d4vid-le/qt-py-esp32-s2-experiment/exports/renders/mockup/bottom.png

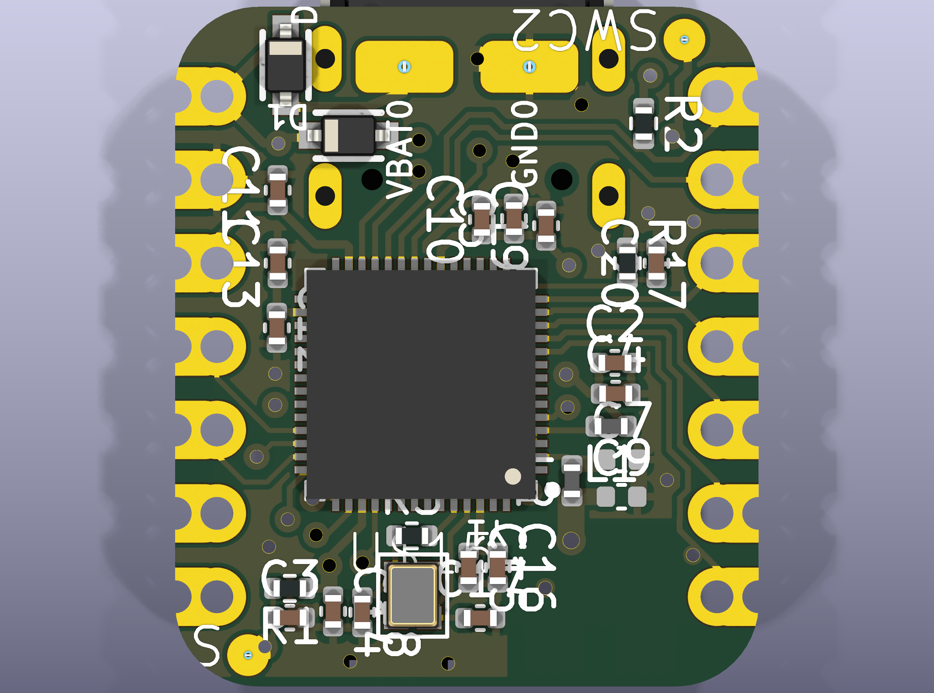
exports/renders/mockup/bottom.png
