d4vid-le/qt-py-esp32-s2-experiment/exports/renders/mockup/top.png

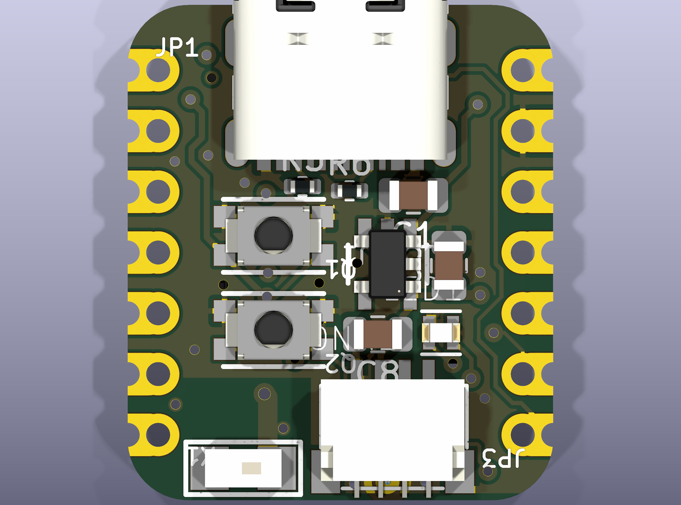
exports/renders/mockup/top.png
