d4vid-le/qt-py-esp32-s2-experiment/reports/gate1-u15-audit.md

# Gate 1 addendum — U$15 (ESP32-S2) pin audit

**Verdict: PASS. 57/57 pads map 1:1 to the ESP32-S2 QFN56 pin table. No
ambiguity remains. Gate 2 may proceed after human review.**

## Exact part number

**ESP32-S2FN4R2** — QFN56, 7×7 mm, 4 MB in-package flash + 2 MB in-package PSRAM.

Evidence:

| Source | What it confirms |
|---|---|
| Adafruit product 5325 | “ESP32-S2 mini-module … 4 MB flash and 2 MB PSRAM” |
| Espressif datasheet **v1.9**, ordering table | `ESP32-S2FN4R2` = 4 MB flash + 2 MB PSRAM, QFN56 |
| Espressif datasheet **v1.9**, package ch. 7 | separate QFN56 package drawing “for ESP32-S2FN4R2” |
| Adafruit-hosted datasheet **v1.1** | 57-pin table used for pin names/functions; **does not list FN4R2** |

The Adafruit-hosted V1.1 predates the FN4R2, which is why the current V1.9 was
used as a supplementary source. V1.9 was downloaded from
`documentation.espressif.com` and kept in `reference/assets/` (gitignored).

## Library discrepancy found (label only)

| Eagle field | Value | Reality |
|---|---|---|
| Symbol | `ESP-32-S2` | okay |
| Device | `QFN54` | **mislabelled** — no QFN54 exists in this family |
| Package | `QFN56_7X7` | correct: 56 pins + exposed pad = **57 pads** |
| Pads | 57, contiguous 1..57 | correct, no gaps or duplicates |

No electrical impact. Recorded as a source quirk.

## Nomenclature differences (all normalized, all match)

| Eagle | Datasheet | Count |
|---|---|---:|
| `IO0` … `IO46` | `GPIO0` … `GPIO46` | 26 |
| `MTD0` (zero) | `MTDO` (letter O) | 1 |
| `VDDA@0/@1/@2` | `VDDA` | 3 |
| `VDD3P3@0/@1` | `VDD3P3` | 2 |
| `GND@0` | `GND` | 1 |

The `@N` suffixes disambiguate repeated names inside one Eagle symbol; they are
not pin numbers.

## Cross-datasheet check

Parsed the 57-pin table from both PDFs independently:

- V1.1: 57 pins, sequential, functions extracted.
- V1.9: 56 numbered pins extracted from Table 2-1; **all 56 names match V1.1**.
- Pin 57 is the exposed pad (`GND`), listed in V1.1 and shown in the V1.9
  QFN56/FN4R2 package drawing rather than Table 2-1.

## FN4R2-specific pins

Pins 29–36 are the in-package flash/PSRAM interface. The datasheet says these
pins “are not recommended for other uses”.

| Pin | Name | Net in this design |
|---:|---|---|
| 29 | SPICS1 | unconnected |
| 30 | VDD_SPI | `VDD_SPI` (C12 0.1 µF + C13 1 µF only) |
| 31 | SPIHD | unconnected |
| 32 | SPIWP | unconnected |
| 33 | SPICS0 | unconnected |
| 34 | SPICLK | unconnected |
| 35 | SPIQ | unconnected |
| 36 | SPID | unconnected |

Leaving 29 and 31–36 unconnected is consistent with in-package memory. VDD_SPI
is deliberately isolated from 3.3 V — this is the Rev C low-power-sleep fix, and
the datasheet allows VDD_SPI to be an output/controlled rail.

## Connectivity summary

- 57 pads audited
- 33 connected to a net
- 24 unconnected (all GPIO/SPI/UART/32k pins, audited in Gate 0)
- 0 name mismatches
- 0 duplicate pads
- 0 gaps

## Full table

Source: `design/u15-pinmap.csv` (generated by `scripts/make_u15_audit.py`).

| Eagle pin | Pad | DS pin | DS name | Net | Function | Check |
|---|---:|---:|---|---|---|---|
| `VDDA@0` | 1 | 1 | `VDDA` | `3.3V` | Analog power supply | match |
| `LNA_IN` | 2 | 2 | `LNA_IN` | `N$2` | RF input and output | match |
| `VDD3P3@0` | 3 | 3 | `VDD3P3` | `VDD3P3` | Analog power supply | match |
| `VDD3P3@1` | 4 | 4 | `VDD3P3` | `VDD3P3` | Analog power supply | match |
| `IO0` | 5 | 5 | `GPIO0` | `IO0` | RTC_GPIO0, GPIO0 | match |
| `IO1` | 6 | 6 | `GPIO1` | `(unconnected)` | RTC_GPIO1, GPIO1, TOUCH1, ADC1_CH0 | match |
| `IO2` | 7 | 7 | `GPIO2` | `(unconnected)` | RTC_GPIO2, GPIO2, TOUCH2, ADC1_CH1 | match |
| `IO3` | 8 | 8 | `GPIO3` | `(unconnected)` | RTC_GPIO3, GPIO3, TOUCH3, ADC1_CH2 | match |
| `IO4` | 9 | 9 | `GPIO4` | `(unconnected)` | RTC_GPIO4, GPIO4, TOUCH4, ADC1_CH3 | match |
| `IO5` | 10 | 10 | `GPIO5` | `TX` | RTC_GPIO5, GPIO5, TOUCH5, ADC1_CH4 | match |
| `IO6` | 11 | 11 | `GPIO6` | `SCL` | RTC_GPIO6, GPIO6, TOUCH6, ADC1_CH5 | match |
| `IO7` | 12 | 12 | `GPIO7` | `SDA` | RTC_GPIO7, GPIO7, TOUCH7, ADC1_CH6 | match |
| `IO8` | 13 | 13 | `GPIO8` | `A3` | RTC_GPIO8, GPIO8, TOUCH8, ADC1_CH7 | match |
| `IO9` | 14 | 14 | `GPIO9` | `A2` | RTC_GPIO9, GPIO9, TOUCH9, ADC1_CH8, FSPIHD | match |
| `IO10` | 15 | 15 | `GPIO10` | `IO10_DBLTAP` | RTC_GPIO10, GPIO10, TOUCH10, ADC1_CH9, FSPICS0, FSPIIO4 | match |
| `IO11` | 16 | 16 | `GPIO11` | `(unconnected)` | RTC_GPIO11, GPIO11, TOUCH11, ADC2_CH0, FSPID, FSPIIO5 | match |
| `IO12` | 17 | 17 | `GPIO12` | `(unconnected)` | RTC_GPIO12, GPIO12, TOUCH12, ADC2_CH1, FSPICLK, FSPIIO6 | match |
| `IO13` | 18 | 18 | `GPIO13` | `(unconnected)` | RTC_GPIO13, GPIO13, TOUCH13, ADC2_CH2, FSPIQ, FSPIIO7 | match |
| `IO14` | 19 | 19 | `GPIO14` | `(unconnected)` | RTC_GPIO14, GPIO14, TOUCH14, ADC2_CH3, FSPIWP, FSPIDQS | match |
| `VDD3P3_RTC` | 20 | 20 | `VDD3P3_RTC` | `3.3V` | Analog power supply | match |
| `XTAL_32K_P` | 21 | 21 | `XTAL_32K_P` | `(unconnected)` | RTC_GPIO15, GPIO15, U0RTS, ADC2_CH4, XTAL_32K_P | match |
| `XTAL_32K_N` | 22 | 22 | `XTAL_32K_N` | `RX` | RTC_GPIO16, GPIO16, U0CTS, ADC2_CH5, XTAL_32K_N | match |
| `DAC_1` | 23 | 23 | `DAC_1` | `A1` | RTC_GPIO17, GPIO17, U1TXD, ADC2_CH6, DAC_1 | match |
| `DAC_2` | 24 | 24 | `DAC_2` | `A0` | RTC_GPIO18, GPIO18, U1RXD, ADC2_CH7, DAC_2 | match |
| `IO19` | 25 | 25 | `GPIO19` | `D-` | RTC_GPIO19, GPIO19, U1RTS, ADC2_CH8, CLK_OUT2, USB_D- | match |
| `IO20` | 26 | 26 | `GPIO20` | `D+` | RTC_GPIO20, GPIO20, U1CTS, ADC2_CH9, CLK_OUT1, USB_D+ | match |
| `VDD3P3_RTC_IO` | 27 | 27 | `VDD3P3_RTC_IO` | `3.3V` | Input power supply for RTC IO | match |
| `IO21` | 28 | 28 | `GPIO21` | `(unconnected)` | RTC_GPIO21, GPIO21 | match |
| `SPICS1` | 29 | 29 | `SPICS1` | `(unconnected)` | SPICS1, GPIO26 | match |
| `VDD_SPI` | 30 | 30 | `VDD_SPI` | `VDD_SPI` | Output power supply: 1.8 V or same as VDD3P3_RTC_IO | match |
| `SPIHD` | 31 | 31 | `SPIHD` | `(unconnected)` | SPIHD, GPIO27 | match |
| `SPIWP` | 32 | 32 | `SPIWP` | `(unconnected)` | SPIWP, GPIO28 | match |
| `SPICS0` | 33 | 33 | `SPICS0` | `(unconnected)` | SPICS0, GPIO29 | match |
| `SPICLK` | 34 | 34 | `SPICLK` | `(unconnected)` | SPICLK, GPIO30 | match |
| `SPIQ` | 35 | 35 | `SPIQ` | `(unconnected)` | SPIQ, GPIO31 | match |
| `SPID` | 36 | 36 | `SPID` | `(unconnected)` | SPID, GPIO32 | match |
| `IO33` | 37 | 37 | `GPIO33` | `(unconnected)` | SPIIO4, GPIO33, FSPIHD | match |
| `IO34` | 38 | 38 | `GPIO34` | `(unconnected)` | SPIIO5, GPIO34, FSPICS0 | match |
| `IO35` | 39 | 39 | `GPIO35` | `MOSI` | SPIIO6, GPIO35, FSPID | match |
| `IO36` | 40 | 40 | `GPIO36` | `SCK` | SPIIO7, GPIO36, FSPICLK | match |
| `IO37` | 41 | 41 | `GPIO37` | `MISO` | SPIDQS, GPIO37, FSPIQ | match |
| `IO38` | 42 | 42 | `GPIO38` | `NEOPIX_PWR` | GPIO38, FSPIWP | match |
| `MTCK` | 43 | 43 | `MTCK` | `NEOPIX` | MTCK, GPIO39, CLK_OUT3 | match |
| `MTD0` | 44 | 44 | `MTDO` | `SCL1` | MTDO, GPIO40, CLK_OUT2 | match |
| `VDD3P3_CPU` | 45 | 45 | `VDD3P3_CPU` | `3.3V` | Input power supply for CPU IO | match |
| `MTDI` | 46 | 46 | `MTDI` | `SDA1` | MTDI, GPIO41, CLK_OUT1 | match |
| `MTMS` | 47 | 47 | `MTMS` | `(unconnected)` | MTMS, GPIO42 | match |
| `U0TXD` | 48 | 48 | `U0TXD` | `(unconnected)` | U0TXD, GPIO43, CLK_OUT1 | match |
| `U0RXD` | 49 | 49 | `U0RXD` | `(unconnected)` | U0RXD, GPIO44, CLK_OUT2 | match |
| `IO45` | 50 | 50 | `GPIO45` | `(unconnected)` | GPIO45 | match |
| `VDDA@1` | 51 | 51 | `VDDA` | `3.3V` | Analog power supply | match |
| `XTAL_N` | 52 | 52 | `XTAL_N` | `N$5` | External crystal output | match |
| `XTAL_P` | 53 | 53 | `XTAL_P` | `N$6` | External crystal input | match |
| `VDDA@2` | 54 | 54 | `VDDA` | `3.3V` | Analog power supply | match |
| `IO46` | 55 | 55 | `GPIO46` | `(unconnected)` | GPIO46 | match |
| `CHIP_PU` | 56 | 56 | `CHIP_PU` | `!RESET` | High: on; low: off. Do not leave floating. | match |
| `GND@0` | 57 | 57 | `GND` | `GND` | Ground (exposed pad) | match |

## Commands used

```sh
curl -o reference/assets/esp32-s2_datasheet.pdf \
  https://cdn-learn.adafruit.com/assets/assets/000/096/705/original/esp32-s2_datasheet_en.pdf
curl -o reference/assets/esp32-s2_datasheet_current.pdf \
  https://documentation.espressif.com/esp32-s2_datasheet_en.pdf

python3 scripts/parse_esp32s2_pins.py \
  reference/assets/esp32-s2_datasheet.pdf reference/imported-kicad/esp32s2-pins.csv

python3 scripts/make_u15_audit.py \
  "reference/eagle/Adafruit QT Py ESP32-S2 Rev C.sch" \
  reference/imported-kicad/esp32s2-pins.csv \
  design/netlist_original.csv \
  design/u15-pinmap.csv
```

## Ambiguities

**None blocking.** One documented limitation: the Adafruit-hosted datasheet
(V1.1) does not cover the FN4R2; the current Espressif V1.9 was used to confirm
the part number and pin numbering. Both agree on all 56 numbered pins.
