d4vid-le/qt-py-esp32-s2-experiment/reports/gate0-nets.md

# Gate 0 — Rev C net detail (from .sch)

Physical pad connections. One row per pad; a pin with several pads appears several times.

## !RESET  (6 pads, class 0)

- `C3.1` — 1uF (_0402NO) pin `1`
- `Q2.A` — reset (BTN_KMR2_4.6X2.8) pin `P`
- `Q2.A'` — reset (BTN_KMR2_4.6X2.8) pin `P1`
- `R1.2` — 10K (_0402NO) pin `2`
- `SWC1.TP` — TPB1,27 (B1,27) pin `TP`
- `U$15.56` —  (QFN56_7X7) pin `CHIP_PU`

## +5V  (10 pads, class 1)

- `C1.1` — 22uF (0805-NO) pin `1`
- `D1.C` —   NSR0320 (SOD-323_MINI) pin `C`
- `D2.C` —   NSR0320 (SOD-323_MINI) pin `C`
- `JP3.7` —  (1X07_CASTEL) pin `7`
- `JP3.7C` —  (1X07_CASTEL) pin `7`
- `SUPPLY1.+5V` —  (symbol) pin `+5V`
- `SUPPLY2.+5V` —  (symbol) pin `+5V`
- `SUPPLY3.+5V` —  (symbol) pin `+5V`
- `U1.1` — AP2112K-3.3 (SOT23-5) pin `IN`
- `U1.3` — AP2112K-3.3 (SOT23-5) pin `EN`

## 3.3V  (34 pads, class 1)

- `C10.1` — 0.1uF (_0402NO) pin `1`
- `C11.1` — 0.1uF (_0402NO) pin `1`
- `C14.1` — 0.1uF (_0402NO) pin `1`
- `C15.1` — 1uF (_0402NO) pin `1`
- `C16.1` — 100pF (_0402NO) pin `1`
- `C19.1` — 1uF (_0402NO) pin `1`
- `C2.1` — 1uF (_0402NO) pin `1`
- `C4.1` — 0.1uF (_0402NO) pin `1`
- `C5.1` — 1uF (_0402NO) pin `1`
- `C6.1` — 22uF (0805-NO) pin `1`
- `C8.1` — 22uF (0805-NO) pin `1`
- `CONN1.2` — STEMMA_I2C_QTSKINNY (JST_SH4_SKINNY) pin `V+`
- `JP3.5` —  (1X07_CASTEL) pin `5`
- `JP3.5C` —  (1X07_CASTEL) pin `5`
- `L1.1` — 2nH (_0402) pin `1`
- `R1.1` — 10K (_0402NO) pin `1`
- `R2.1` — 10K (_0402NO) pin `1`
- `U$10.3.3V` —  (symbol) pin `3.3V`
- `U$15.1` —  (QFN56_7X7) pin `VDDA@0`
- `U$15.20` —  (QFN56_7X7) pin `VDD3P3_RTC`
- `U$15.27` —  (QFN56_7X7) pin `VDD3P3_RTC_IO`
- `U$15.45` —  (QFN56_7X7) pin `VDD3P3_CPU`
- `U$15.51` —  (QFN56_7X7) pin `VDDA@1`
- `U$15.54` —  (QFN56_7X7) pin `VDDA@2`
- `U$16.3.3V` —  (symbol) pin `3.3V`
- `U$17.3.3V` —  (symbol) pin `3.3V`
- `U$19.3.3V` —  (symbol) pin `3.3V`
- `U$2.3.3V` —  (symbol) pin `3.3V`
- `U$20.3.3V` —  (symbol) pin `3.3V`
- `U$21.3.3V` —  (symbol) pin `3.3V`
- `U$23.3.3V` —  (symbol) pin `3.3V`
- `U$24.3.3V` —  (symbol) pin `3.3V`
- `U$4.3.3V` —  (symbol) pin `3.3V`
- `U1.5` — AP2112K-3.3 (SOT23-5) pin `OUT`

## A0  (4 pads, class 0)

- `JP1.1` —  (1X07_CASTEL) pin `1`
- `JP1.1C` —  (1X07_CASTEL) pin `1`
- `R2.2` — 10K (_0402NO) pin `2`
- `U$15.24` —  (QFN56_7X7) pin `DAC_2`

## A1  (3 pads, class 0)

- `JP1.2` —  (1X07_CASTEL) pin `2`
- `JP1.2C` —  (1X07_CASTEL) pin `2`
- `U$15.23` —  (QFN56_7X7) pin `DAC_1`

## A2  (3 pads, class 0)

- `JP1.3` —  (1X07_CASTEL) pin `3`
- `JP1.3C` —  (1X07_CASTEL) pin `3`
- `U$15.14` —  (QFN56_7X7) pin `IO9`

## A3  (3 pads, class 0)

- `JP1.4` —  (1X07_CASTEL) pin `4`
- `JP1.4C` —  (1X07_CASTEL) pin `4`
- `U$15.13` —  (QFN56_7X7) pin `IO8`

## CC1  (2 pads, class 0)

- `R6.2` — 5.1K (_0402NO) pin `2`
- `X6.A5` — USB TYPE C (USB_C_CUSB31-CFM2AX-01-X) pin `CC1`

## CC2  (2 pads, class 0)

- `R5.2` — 5.1K (_0402NO) pin `2`
- `X6.B5` — USB TYPE C (USB_C_CUSB31-CFM2AX-01-X) pin `CC2`

## D+  (3 pads, class 0)

- `U$15.26` —  (QFN56_7X7) pin `IO20`
- `X6.A6` — USB TYPE C (USB_C_CUSB31-CFM2AX-01-X) pin `D+`
- `X6.B6` — USB TYPE C (USB_C_CUSB31-CFM2AX-01-X) pin `D+`

## D-  (3 pads, class 0)

- `U$15.25` —  (QFN56_7X7) pin `IO19`
- `X6.A7` — USB TYPE C (USB_C_CUSB31-CFM2AX-01-X) pin `D-`
- `X6.B7` — USB TYPE C (USB_C_CUSB31-CFM2AX-01-X) pin `D-`

## GND  (70 pads, class 1)

- `C1.2` — 22uF (0805-NO) pin `2`
- `C10.2` — 0.1uF (_0402NO) pin `2`
- `C11.2` — 0.1uF (_0402NO) pin `2`
- `C12.2` — 0.1uF (_0402NO) pin `2`
- `C13.2` — 1uF (_0402NO) pin `2`
- `C14.2` — 0.1uF (_0402NO) pin `2`
- `C15.2` — 1uF (_0402NO) pin `2`
- `C16.2` — 100pF (_0402NO) pin `2`
- `C17.2` — 16pF (_0402NO) pin `2`
- `C18.2` — 16pF (_0402NO) pin `2`
- `C19.2` — 1uF (_0402NO) pin `2`
- `C2.2` — 1uF (_0402NO) pin `2`
- `C20.2` — 1uF (_0402NO) pin `2`
- `C3.2` — 1uF (_0402NO) pin `2`
- `C4.2` — 0.1uF (_0402NO) pin `2`
- `C5.2` — 1uF (_0402NO) pin `2`
- `C6.2` — 22uF (0805-NO) pin `2`
- `C7.2` — TBD (_0402NO) pin `2`
- `C8.2` — 22uF (0805-NO) pin `2`
- `C9.2` — TBD (_0402NO) pin `2`
- `CONN1.1` — STEMMA_I2C_QTSKINNY (JST_SH4_SKINNY) pin `GND`
- `CONN1.MT1` — STEMMA_I2C_QTSKINNY (JST_SH4_SKINNY) pin `MT`
- `CONN1.MT2` — STEMMA_I2C_QTSKINNY (JST_SH4_SKINNY) pin `MT`
- `GND.P$1` —  (TESTPOINT_MINUS_1X3MM) pin `P$1`
- `GND1.GND` —  (symbol) pin `GND`
- `GND10.GND` —  (symbol) pin `GND`
- `GND11.GND` —  (symbol) pin `GND`
- `GND12.GND` —  (symbol) pin `GND`
- `GND13.GND` —  (symbol) pin `GND`
- `GND14.GND` —  (symbol) pin `GND`
- `GND15.GND` —  (symbol) pin `GND`
- `GND16.GND` —  (symbol) pin `GND`
- `GND17.GND` —  (symbol) pin `GND`
- `GND18.GND` —  (symbol) pin `GND`
- `GND19.GND` —  (symbol) pin `GND`
- `GND2.GND` —  (symbol) pin `GND`
- `GND20.GND` —  (symbol) pin `GND`
- `GND21.GND` —  (symbol) pin `GND`
- `GND22.GND` —  (symbol) pin `GND`
- `GND23.GND` —  (symbol) pin `GND`
- `GND24.GND` —  (symbol) pin `GND`
- `GND25.GND` —  (symbol) pin `GND`
- `GND26.GND` —  (symbol) pin `GND`
- `GND27.GND` —  (symbol) pin `GND`
- `GND3.GND` —  (symbol) pin `GND`
- `GND4.GND` —  (symbol) pin `GND`
- `GND5.GND` —  (symbol) pin `GND`
- `GND6.GND` —  (symbol) pin `GND`
- `GND7.GND` —  (symbol) pin `GND`
- `GND8.GND` —  (symbol) pin `GND`
- `GND9.GND` —  (symbol) pin `GND`
- `JP3.6` —  (1X07_CASTEL) pin `6`
- `JP3.6C` —  (1X07_CASTEL) pin `6`
- `LED1.4` — WS2812B_SK6805_1515 (SK6805_1515) pin `GND`
- `Q1.B` — BOOT0 (BTN_KMR2_4.6X2.8) pin `S`
- `Q1.B'` — BOOT0 (BTN_KMR2_4.6X2.8) pin `S1`
- `Q2.B` — reset (BTN_KMR2_4.6X2.8) pin `S`
- `Q2.B'` — reset (BTN_KMR2_4.6X2.8) pin `S1`
- `R17.1` — 1Meg (_0402NO) pin `1`
- `R5.1` — 5.1K (_0402NO) pin `1`
- `R6.1` — 5.1K (_0402NO) pin `1`
- `U$1.GND` —  (symbol) pin `GND`
- `U$14.GND` —  (symbol) pin `GND`
- `U$15.57` —  (QFN56_7X7) pin `GND@0`
- `U$26.GND` —  (symbol) pin `GND`
- `U$40.GND` —  (symbol) pin `GND`
- `U$9.GND` —  (symbol) pin `GND`
- `U1.2` — AP2112K-3.3 (SOT23-5) pin `GND`
- `X6.A1B12` — USB TYPE C (USB_C_CUSB31-CFM2AX-01-X) pin `GND`
- `X6.B1A12` — USB TYPE C (USB_C_CUSB31-CFM2AX-01-X) pin `GND`

## IO0  (4 pads, class 0)

- `Q1.A` — BOOT0 (BTN_KMR2_4.6X2.8) pin `P`
- `Q1.A'` — BOOT0 (BTN_KMR2_4.6X2.8) pin `P1`
- `SWC2.TP` — TPB1,27 (B1,27) pin `TP`
- `U$15.5` —  (QFN56_7X7) pin `IO0`

## IO10_DBLTAP  (3 pads, class 0)

- `C20.1` — 1uF (_0402NO) pin `1`
- `R17.2` — 1Meg (_0402NO) pin `2`
- `U$15.15` —  (QFN56_7X7) pin `IO10`

## MISO  (3 pads, class 0)

- `JP3.3` —  (1X07_CASTEL) pin `3`
- `JP3.3C` —  (1X07_CASTEL) pin `3`
- `U$15.41` —  (QFN56_7X7) pin `IO37`

## MOSI  (3 pads, class 0)

- `JP3.4` —  (1X07_CASTEL) pin `4`
- `JP3.4C` —  (1X07_CASTEL) pin `4`
- `U$15.39` —  (QFN56_7X7) pin `IO35`

## N$2  (3 pads, class 0)

- `C7.1` — TBD (_0402NO) pin `1`
- `L2.2` — 0 ohm (_0402) pin `2`
- `U$15.2` —  (QFN56_7X7) pin `LNA_IN`

## N$3  (3 pads, class 0)

- `C9.1` — TBD (_0402NO) pin `1`
- `L2.1` — 0 ohm (_0402) pin `1`
- `X1.FP` —  (ANT_2450AT18B100) pin `P$1`

## N$5  (2 pads, class 0)

- `R3.2` — 0 (_0402NO) pin `2`
- `U$15.52` —  (QFN56_7X7) pin `XTAL_N`

## N$6  (3 pads, class 0)

- `C17.1` — 16pF (_0402NO) pin `1`
- `U$15.53` —  (QFN56_7X7) pin `XTAL_P`
- `Y1.3` — 40MHz (CRYSTAL_2X1.6) pin `2`

## N$7  (3 pads, class 0)

- `C18.1` — 16pF (_0402NO) pin `1`
- `R3.1` — 0 (_0402NO) pin `1`
- `Y1.1` — 40MHz (CRYSTAL_2X1.6) pin `1`

## NEOPIX  (2 pads, class 0)

- `LED1.1` — WS2812B_SK6805_1515 (SK6805_1515) pin `DI`
- `U$15.43` —  (QFN56_7X7) pin `MTCK`

## NEOPIX_PWR  (2 pads, class 0)

- `LED1.2` — WS2812B_SK6805_1515 (SK6805_1515) pin `VDD`
- `U$15.42` —  (QFN56_7X7) pin `IO38`

## RX  (3 pads, class 0)

- `JP3.1` —  (1X07_CASTEL) pin `1`
- `JP3.1C` —  (1X07_CASTEL) pin `1`
- `U$15.22` —  (QFN56_7X7) pin `XTAL_32K_N`

## SCK  (3 pads, class 0)

- `JP3.2` —  (1X07_CASTEL) pin `2`
- `JP3.2C` —  (1X07_CASTEL) pin `2`
- `U$15.40` —  (QFN56_7X7) pin `IO36`

## SCL  (3 pads, class 0)

- `JP1.6` —  (1X07_CASTEL) pin `6`
- `JP1.6C` —  (1X07_CASTEL) pin `6`
- `U$15.11` —  (QFN56_7X7) pin `IO6`

## SCL1  (2 pads, class 0)

- `CONN1.4` — STEMMA_I2C_QTSKINNY (JST_SH4_SKINNY) pin `SCL`
- `U$15.44` —  (QFN56_7X7) pin `MTD0`

## SDA  (3 pads, class 0)

- `JP1.5` —  (1X07_CASTEL) pin `5`
- `JP1.5C` —  (1X07_CASTEL) pin `5`
- `U$15.12` —  (QFN56_7X7) pin `IO7`

## SDA1  (2 pads, class 0)

- `CONN1.3` — STEMMA_I2C_QTSKINNY (JST_SH4_SKINNY) pin `SDA`
- `U$15.46` —  (QFN56_7X7) pin `MTDI`

## TX  (3 pads, class 0)

- `JP1.7` —  (1X07_CASTEL) pin `7`
- `JP1.7C` —  (1X07_CASTEL) pin `7`
- `U$15.10` —  (QFN56_7X7) pin `IO5`

## VBAT  (2 pads, class 0)

- `D2.A` —   NSR0320 (SOD-323_MINI) pin `A`
- `VBAT.P$1` —  (TESTPOINT_PLUS_1X3MM) pin `P$1`

## VBUS  (4 pads, class 1)

- `D1.A` —   NSR0320 (SOD-323_MINI) pin `A`
- `U$5.VBUS` —  (symbol) pin `VBUS`
- `X6.A4B9` — USB TYPE C (USB_C_CUSB31-CFM2AX-01-X) pin `VBUS`
- `X6.B4A9` — USB TYPE C (USB_C_CUSB31-CFM2AX-01-X) pin `VBUS`

## VDD3P3  (3 pads, class 0)

- `L1.2` — 2nH (_0402) pin `2`
- `U$15.3` —  (QFN56_7X7) pin `VDD3P3@0`
- `U$15.4` —  (QFN56_7X7) pin `VDD3P3@1`

## VDD_SPI  (3 pads, class 1)

- `C12.1` — 0.1uF (_0402NO) pin `1`
- `C13.1` — 1uF (_0402NO) pin `1`
- `U$15.30` —  (QFN56_7X7) pin `VDD_SPI`
