d4vid-le/qt-py-esp32-s2-experiment/exports/docs/drill-report.txt

Drill report for qt-py-esp32-s2.kicad_pcb
Created on 2026-10-27T13:43:44

Copper Layer Stackup:
    =============================================================
    L1 :  F.Cu                      front
    L2 :  In1.Cu                    in1
    L3 :  In2.Cu                    in2
    L4 :  B.Cu                      back

Drill file 'qt-py-esp32-s2-PTH.drl' contains
    plated through holes:
    =============================================================
    T1  0.394mm  0.0155"  (11 holes))
    T2  0.400mm  0.0157"  (31 holes))
    T3  0.500mm  0.0197"  (1 hole)
    T4  0.600mm  0.0236"  (4 holes))
    T5  1.000mm  0.0394"  (28 holes))

    Total plated holes count 75

Drill file 'qt-py-esp32-s2-NPTH.drl' contains
    unplated through holes:
    =============================================================
    T1  0.650mm  0.0256"  (2 holes))

    Total unplated holes count 2
