d4vid-le/qt-py-esp32-s2-experiment/exports/renders/2d-copper.png

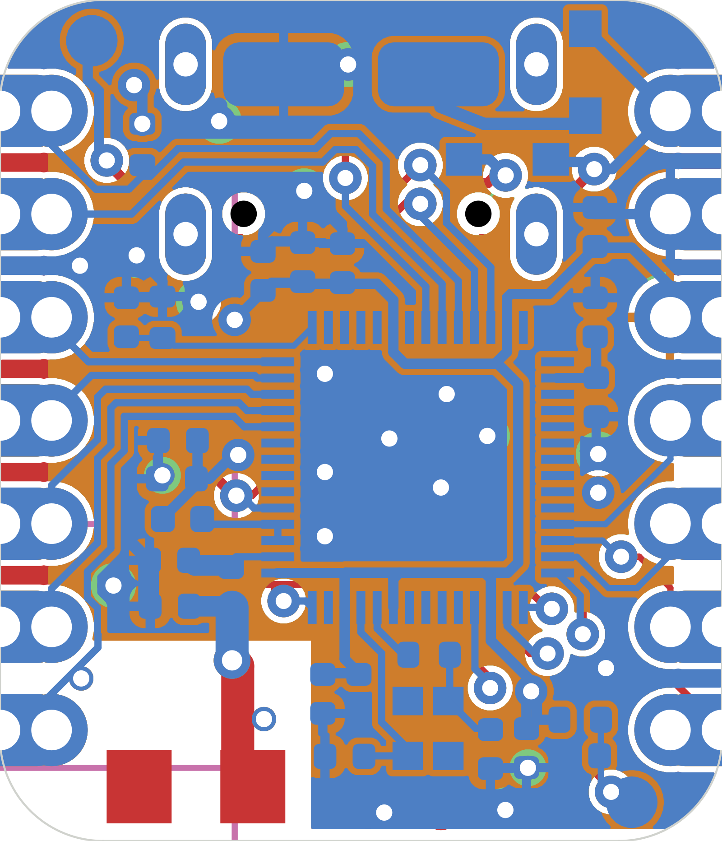
exports/renders/2d-copper.png
