d4vid-le/qt-py-esp32-s2-experiment/exports/renders/3d-bottom.png

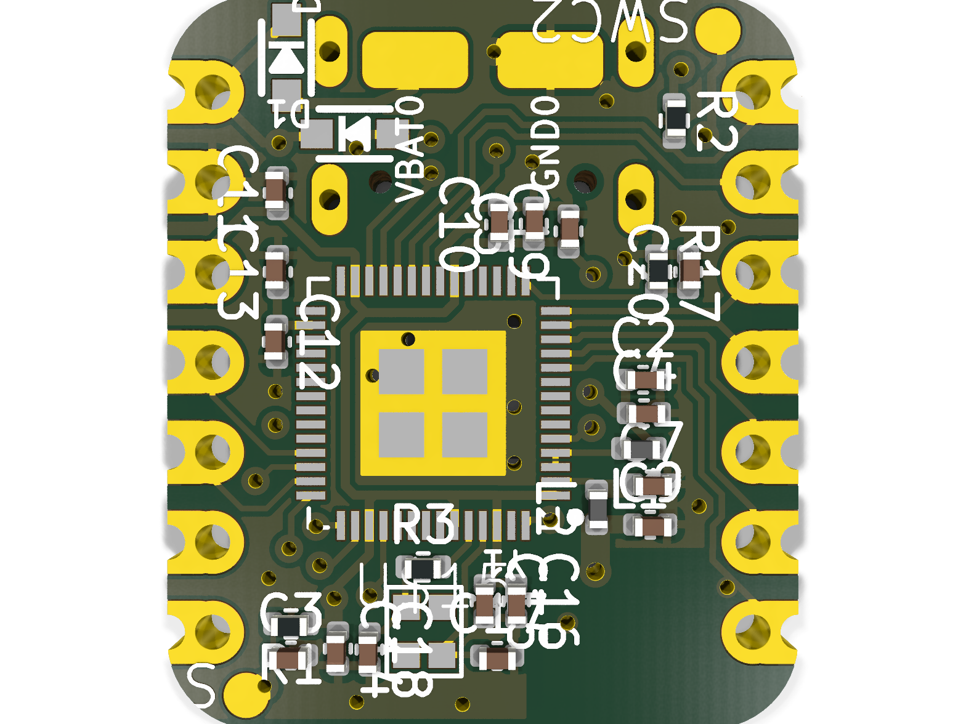
exports/renders/3d-bottom.png
