d4vid-le/qt-py-esp32-s2-experiment/exports/renders/mockup/top-iso.png

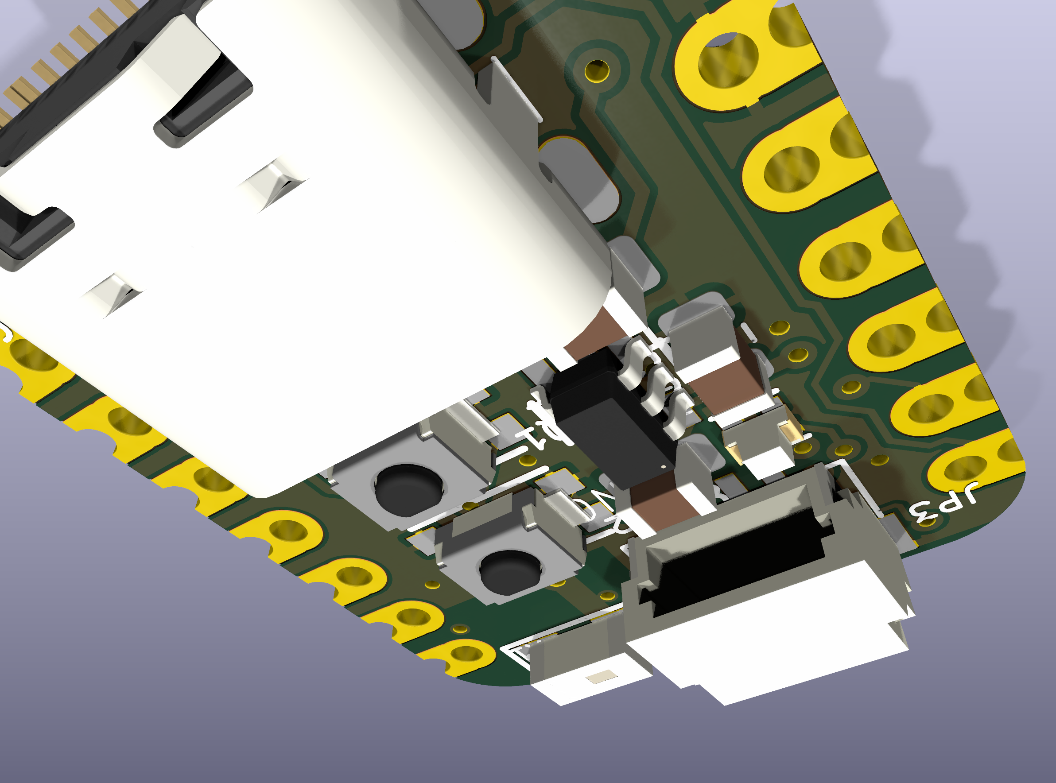
exports/renders/mockup/top-iso.png
