d4vid-le/qt-py-esp32-s2-experiment/renders/gate1-imported-top.png

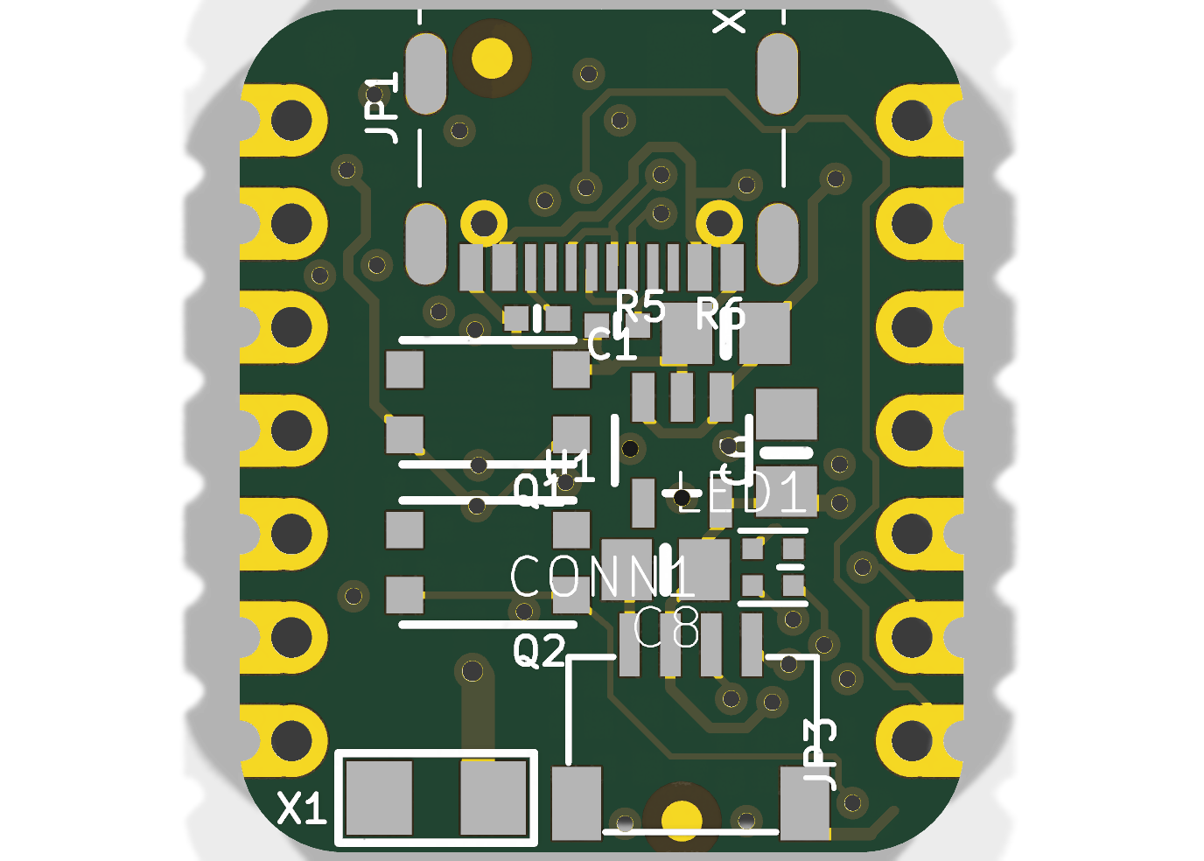
renders/gate1-imported-top.png
