d4vid-le/qt-py-esp32-s2-experiment/renders/gate2-schematic.png

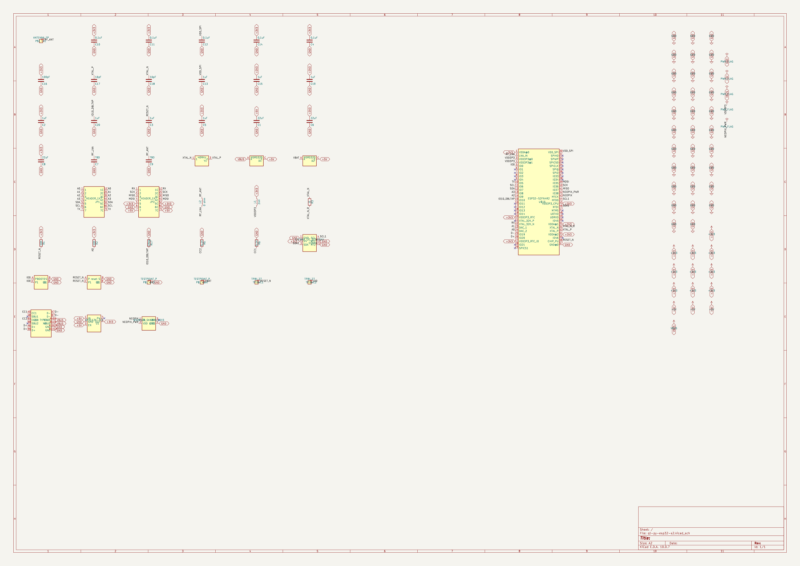
renders/gate2-schematic.png
