d4vid-le/qt-py-esp32-s2-experiment/renders/gate3-3d-top.png

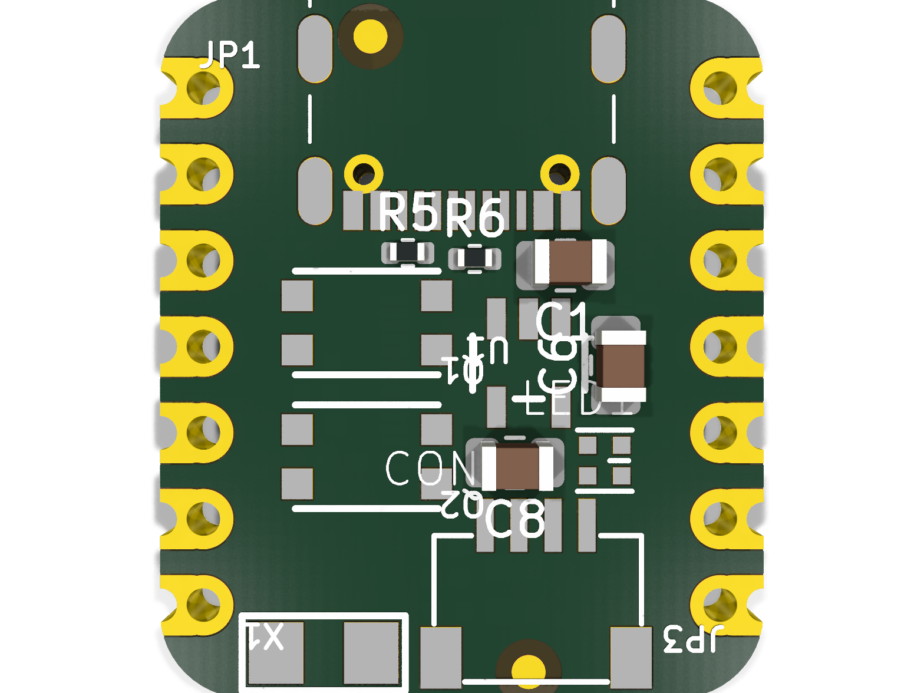
renders/gate3-3d-top.png
