d4vid-le/qt-py-esp32-s2-experiment/renders/gate4-2d.png

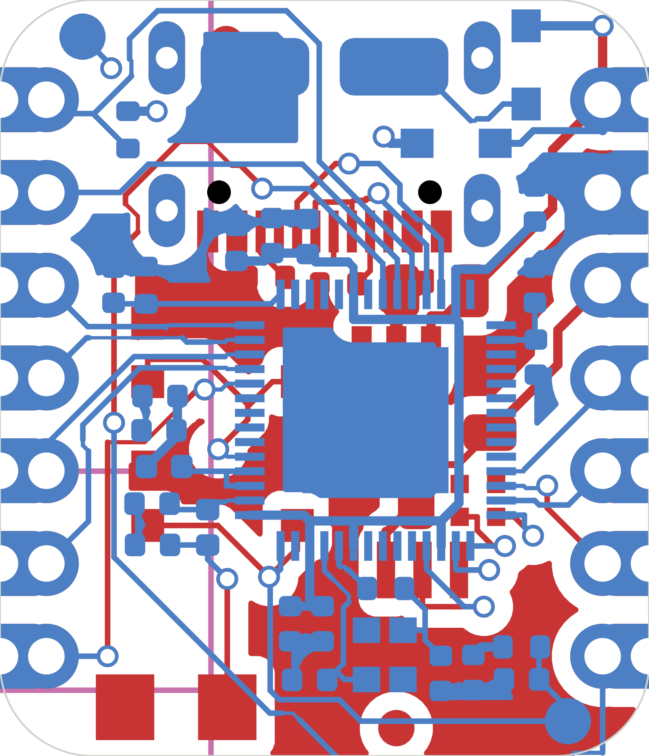
renders/gate4-2d.png
