d4vid-le/qt-py-esp32-s2-experiment/design/gate2-components.csv

ref | value | device | package | symbol | footprint | dnp | note
C1 | 22uF | CAP_CERAMIC | 0805-NO | Device:C | Capacitor_SMD:C_0805_2012Metric | no
C10 | 0.1uF | CAP_CERAMIC | _0402NO | Device:C | Capacitor_SMD:C_0402_1005Metric | no
C11 | 0.1uF | CAP_CERAMIC | _0402NO | Device:C | Capacitor_SMD:C_0402_1005Metric | no
C12 | 0.1uF | CAP_CERAMIC | _0402NO | Device:C | Capacitor_SMD:C_0402_1005Metric | no
C13 | 1uF | CAP_CERAMIC | _0402NO | Device:C | Capacitor_SMD:C_0402_1005Metric | no
C14 | 0.1uF | CAP_CERAMIC | _0402NO | Device:C | Capacitor_SMD:C_0402_1005Metric | no
C15 | 1uF | CAP_CERAMIC | _0402NO | Device:C | Capacitor_SMD:C_0402_1005Metric | no
C16 | 100pF | CAP_CERAMIC | _0402NO | Device:C | Capacitor_SMD:C_0402_1005Metric | no
C17 | 16pF | CAP_CERAMIC | _0402NO | Device:C | Capacitor_SMD:C_0402_1005Metric | no
C18 | 16pF | CAP_CERAMIC | _0402NO | Device:C | Capacitor_SMD:C_0402_1005Metric | no
C19 | 1uF | CAP_CERAMIC | _0402NO | Device:C | Capacitor_SMD:C_0402_1005Metric | no
C2 | 1uF | CAP_CERAMIC | _0402NO | Device:C | Capacitor_SMD:C_0402_1005Metric | no
C20 | 1uF | CAP_CERAMIC | _0402NO | Device:C | Capacitor_SMD:C_0402_1005Metric | no
C3 | 1uF | CAP_CERAMIC | _0402NO | Device:C | Capacitor_SMD:C_0402_1005Metric | no
C4 | 0.1uF | CAP_CERAMIC | _0402NO | Device:C | Capacitor_SMD:C_0402_1005Metric | no
C5 | 1uF | CAP_CERAMIC | _0402NO | Device:C | Capacitor_SMD:C_0402_1005Metric | no
C6 | 22uF | CAP_CERAMIC | 0805-NO | Device:C | Capacitor_SMD:C_0805_2012Metric | no
C7 | TBD | CAP_CERAMIC | _0402NO | Device:C | Capacitor_SMD:C_0402_1005Metric | yes | TBD in source; DNP; antenna match placeholder
C8 | 22uF | CAP_CERAMIC | 0805-NO | Device:C | Capacitor_SMD:C_0805_2012Metric | no
C9 | TBD | CAP_CERAMIC | _0402NO | Device:C | Capacitor_SMD:C_0402_1005Metric | yes | TBD in source; DNP; antenna match placeholder
CONN1 | STEMMA_I2C_QTSKINNY | STEMMA_I2C | JST_SH4_SKINNY | qt-py-esp32-s2:JST_SH4 | qt-py:JST_SH4_SKINNY | no
D1 | NSR0320 | DIODE | SOD-323_MINI | qt-py-esp32-s2:DIODE_A_C | qt-py:SOD-323_MINI | no
D2 | NSR0320 | DIODE | SOD-323_MINI | qt-py-esp32-s2:DIODE_A_C | qt-py:SOD-323_MINI | no
GND |  | TESTPOINT | TESTPOINT_MINUS_1X3MM | qt-py-esp32-s2:TESTPOINT_P | qt-py:TESTPOINT_MINUS_1X3MM | no
JP1 |  | HEADER-1X7 | 1X07_CASTEL | qt-py-esp32-s2:HEADER_1X7 | qt-py:1X07_CASTEL | no
JP3 |  | HEADER-1X7 | 1X07_CASTEL | qt-py-esp32-s2:HEADER_1X7 | qt-py:1X07_CASTEL | no
L1 | 2nH | INDUCTOR | _0402 | Device:L | Inductor_SMD:L_0402_1005Metric | no
L2 | 0 ohm | INDUCTOR | _0402 | Device:L | Inductor_SMD:L_0402_1005Metric | no
LED1 | WS2812B_SK6805_1515 | WS2812B | SK6805_1515 | qt-py-esp32-s2:WS2812B | qt-py:SK6805_1515 | no
Q1 | BOOT0 | SWITCH_TACT_SMT | BTN_KMR2_4.6X2.8 | qt-py-esp32-s2:TACT_4 | qt-py:BTN_KMR2_4.6X2.8 | no
Q2 | reset | SWITCH_TACT_SMT | BTN_KMR2_4.6X2.8 | qt-py-esp32-s2:TACT_4 | qt-py:BTN_KMR2_4.6X2.8 | no
R1 | 10K | RESISTOR | _0402NO | Device:R | Resistor_SMD:R_0402_1005Metric | no
R17 | 1Meg | RESISTOR | _0402NO | Device:R | Resistor_SMD:R_0402_1005Metric | no
R2 | 10K | RESISTOR | _0402NO | Device:R | Resistor_SMD:R_0402_1005Metric | no
R3 | 0 | RESISTOR | _0402NO | Device:R | Resistor_SMD:R_0402_1005Metric | no | 0R in series with crystal XTAL_N; source quirk, preserved
R5 | 5.1K | RESISTOR | _0402NO | Device:R | Resistor_SMD:R_0402_1005Metric | no
R6 | 5.1K | RESISTOR | _0402NO | Device:R | Resistor_SMD:R_0402_1005Metric | no
SWC1 | TPB1,27 | TP | B1,27 | qt-py-esp32-s2:TESTPAD_TP | qt-py:B1_27 | no
SWC2 | TPB1,27 | TP | B1,27 | qt-py-esp32-s2:TESTPAD_TP | qt-py:B1_27 | no
U$15 |  | ESP32-S2 | QFN56_7X7 | qt-py-esp32-s2:ESP32-S2FN4R2 | qt-py:QFN56_7X7 | no
U1 | AP2112K-3.3 | VREG_SOT23-5 | SOT23-5 | qt-py-esp32-s2:VREG_5 | qt-py:SOT23-5 | no
VBAT |  | TESTPOINT | TESTPOINT_PLUS_1X3MM | qt-py-esp32-s2:TESTPOINT_P | qt-py:TESTPOINT_PLUS_1X3MM | no
X1 |  | ANTENNA_JOHANSON_2450AT18B100 | ANT_2450AT18B100 | qt-py-esp32-s2:ANTENNA_FP | qt-py:ANT_2450AT18B100 | no
X6 | USB TYPE C | USB_C | USB_C_CUSB31-CFM2AX-01-X | qt-py-esp32-s2:USB_C | qt-py:USB_C_CUSB31-CFM2AX-01-X | no
Y1 | 40MHz | CRYSTAL | CRYSTAL_2X1.6 | qt-py-esp32-s2:CRYSTAL_2PIN | qt-py:CRYSTAL_2X1.6 | no
