d4vid-le/qt-py-esp32-s2-experiment/design/bom_clean.csv

item | qty | refs | value | device | package | library | populate | dnp | note
1 | 1 | X1 |  | ANTENNA_JOHANSON_2450AT18B100 | ANT_2450AT18B100 | adafruit_wireless | yes | no
2 | 5 | C10 C11 C12 C14 C4 | 0.1uF | CAP_CERAMIC | _0402NO | microbuilder | yes | no
3 | 1 | C16 | 100pF | CAP_CERAMIC | _0402NO | microbuilder | yes | no
4 | 2 | C17 C18 | 16pF | CAP_CERAMIC | _0402NO | microbuilder | yes | no
5 | 7 | C13 C15 C19 C2 C20 C3 C5 | 1uF | CAP_CERAMIC | _0402NO | microbuilder | yes | no
6 | 3 | C1 C6 C8 | 22uF | CAP_CERAMIC | 0805-NO | microbuilder | yes | no
7 | 2 | C7 C9 | TBD | CAP_CERAMIC | _0402NO | microbuilder | no | yes | TBD in source; DNP; antenna match placeholder
8 | 1 | Y1 | 40MHz | CRYSTAL | CRYSTAL_2X1.6 | microbuilder | yes | no
9 | 2 | D1 D2 | NSR0320 | DIODE | SOD-323_MINI | microbuilder | yes | no
10 | 1 | U$15 |  | ESP32-S2 | QFN56_7X7 | adafruit_wireless | yes | no
11 | 2 | JP1 JP3 |  | HEADER-1X7 | 1X07_CASTEL | microbuilder | yes | no
12 | 1 | L2 | 0 ohm | INDUCTOR | _0402 | microbuilder | yes | no
13 | 1 | L1 | 2nH | INDUCTOR | _0402 | microbuilder | yes | no
14 | 1 | R3 | 0 | RESISTOR | _0402NO | microbuilder | yes | no | 0R in series with crystal XTAL_N; source quirk, preserved
15 | 2 | R1 R2 | 10K | RESISTOR | _0402NO | microbuilder | yes | no
16 | 1 | R17 | 1Meg | RESISTOR | _0402NO | microbuilder | yes | no
17 | 2 | R5 R6 | 5.1K | RESISTOR | _0402NO | microbuilder | yes | no
18 | 1 | CONN1 | STEMMA_I2C_QTSKINNY | STEMMA_I2C | JST_SH4_SKINNY | microbuilder | yes | no
19 | 1 | Q1 | BOOT0 | SWITCH_TACT_SMT | BTN_KMR2_4.6X2.8 | adafruit_electromech | yes | no
20 | 1 | Q2 | reset | SWITCH_TACT_SMT | BTN_KMR2_4.6X2.8 | adafruit_electromech | yes | no
21 | 1 | GND |  | TESTPOINT | TESTPOINT_MINUS_1X3MM | microbuilder | yes | no
22 | 1 | VBAT |  | TESTPOINT | TESTPOINT_PLUS_1X3MM | microbuilder | yes | no
23 | 2 | SWC1 SWC2 | TPB1,27 | TP | B1,27 | testpad | yes | no
24 | 1 | X6 | USB TYPE C | USB_C | USB_C_CUSB31-CFM2AX-01-X | adafruit_electromech | yes | no
25 | 1 | U1 | AP2112K-3.3 | VREG_SOT23-5 | SOT23-5 | adafruit_power | yes | no
26 | 1 | LED1 | WS2812B_SK6805_1515 | WS2812B | SK6805_1515 | microbuilder | yes | no
