d4vid-le/qt-py-esp32-s2-experiment/design/bom_symbols.csv

qty | refs | deviceset | kind
3 | SUPPLY1 SUPPLY2 SUPPLY3 | +5V | power_symbol
10 | U$10 U$16 U$17 U$19 U$2 U$20 U$21 U$23 U$24 U$4 | 3.3V | power_symbol
2 | U$6 U$8 | FIDUCIAL | fiducial
1 | FRAME1 | FRAME_A_L | frame
32 | GND1 GND10 GND11 GND12 GND13 GND14 GND15 GND16 GND17 GND18 GND19 GND2 GND20 GND21 GND22 GND23 GND24 GND25 GND26 GND27 GND3 GND4 GND5 GND6 GND7 GND8 GND9 U$1 U$14 U$26 U$40 U$9 | GND | power_symbol
1 | U$5 | VBUS | power_symbol
