d4vid-le/qt-py-esp32-s2-experiment/design/bom_original.csv

item | qty | refs | value | deviceset | device | package | library | kind | dnp_note
1 | 3 | SUPPLY1 SUPPLY2 SUPPLY3 |  | +5V |  |  | supply2 | power_symbol
2 | 10 | U$10 U$16 U$17 U$19 U$2 U$20 U$21 U$23 U$24 U$4 |  | 3.3V |  |  | microbuilder | power_symbol
3 | 1 | X1 |  | ANTENNA_JOHANSON_2450AT18B100 |  | ANT_2450AT18B100 | adafruit_wireless | component
4 | 5 | C10 C11 C12 C14 C4 | 0.1uF | CAP_CERAMIC | _0402NO | _0402NO | microbuilder | component
5 | 1 | C16 | 100pF | CAP_CERAMIC | _0402NO | _0402NO | microbuilder | component
6 | 2 | C17 C18 | 16pF | CAP_CERAMIC | _0402NO | _0402NO | microbuilder | component
7 | 7 | C13 C15 C19 C2 C20 C3 C5 | 1uF | CAP_CERAMIC | _0402NO | _0402NO | microbuilder | component
8 | 3 | C1 C6 C8 | 22uF | CAP_CERAMIC | 0805-NOOUTLINE | 0805-NO | microbuilder | component
9 | 2 | C7 C9 | TBD | CAP_CERAMIC | _0402NO | _0402NO | microbuilder | component | value TBD in source
10 | 1 | Y1 | 40MHz | CRYSTAL | _2X1.6MM | CRYSTAL_2X1.6 | microbuilder | component
11 | 2 | D1 D2 | NSR0320 | DIODE | _SOD323MINI | SOD-323_MINI | microbuilder | component
12 | 1 | U$15 |  | ESP32-S2 | QFN54 | QFN56_7X7 | adafruit_wireless | component
13 | 2 | U$6 U$8 |  | FIDUCIAL | _1MM | FIDUCIAL_1MM | microbuilder | fiducial
14 | 1 | FRAME1 |  | FRAME_A_L |  |  | frames | frame
15 | 32 | GND1 GND10 GND11 GND12 GND13 GND14 GND15 GND16 GND17 GND18 GND19 GND2 GND20 GND21 GND22 GND23 GND24 GND25 GND26 GND27 GND3 GND4 GND5 GND6 GND7 GND8 GND9 U$1 U$14 U$26 U$40 U$9 |  | GND |  |  | supply1 | power_symbol
16 | 2 | JP1 JP3 |  | HEADER-1X7 | _CASTEL | 1X07_CASTEL | microbuilder | component
17 | 1 | L2 | 0 ohm | INDUCTOR | _0402 | _0402 | microbuilder | component | zero-ohm link
18 | 1 | L1 | 2nH | INDUCTOR | _0402 | _0402 | microbuilder | component
19 | 1 | R3 | 0 | RESISTOR | _0402NO | _0402NO | microbuilder | component | zero-ohm link
20 | 2 | R1 R2 | 10K | RESISTOR | _0402NO | _0402NO | microbuilder | component
21 | 1 | R17 | 1Meg | RESISTOR | _0402NO | _0402NO | microbuilder | component
22 | 2 | R5 R6 | 5.1K | RESISTOR | _0402NO | _0402NO | microbuilder | component
23 | 1 | CONN1 | STEMMA_I2C_QTSKINNY | STEMMA_I2C | _QTSKINNY | JST_SH4_SKINNY | microbuilder | component
24 | 1 | Q1 | BOOT0 | SWITCH_TACT_SMT | 4.6X2.8 | BTN_KMR2_4.6X2.8 | adafruit_electromech | component
25 | 1 | Q2 | reset | SWITCH_TACT_SMT | 4.6X2.8 | BTN_KMR2_4.6X2.8 | adafruit_electromech | component
26 | 1 | GND |  | TESTPOINT | _MINUS | TESTPOINT_MINUS_1X3MM | microbuilder | component
27 | 1 | VBAT |  | TESTPOINT | _PLUS13 | TESTPOINT_PLUS_1X3MM | microbuilder | component
28 | 2 | SWC1 SWC2 | TPB1,27 | TP | B1,27 | B1,27 | testpad | component
29 | 1 | X6 | USB TYPE C | USB_C |  | USB_C_CUSB31-CFM2AX-01-X | adafruit_electromech | component
30 | 1 | U$5 |  | VBUS |  |  | microbuilder | power_symbol
31 | 1 | U1 | AP2112K-3.3 | VREG_SOT23-5 |  | SOT23-5 | adafruit_power | component
32 | 1 | LED1 | WS2812B_SK6805_1515 | WS2812B | _SK6805_1515 | SK6805_1515 | microbuilder | component
