d4vid-le/qt-py-esp32-s2-experiment/exports/renders/qt-py-esp32-s2-assembled.step

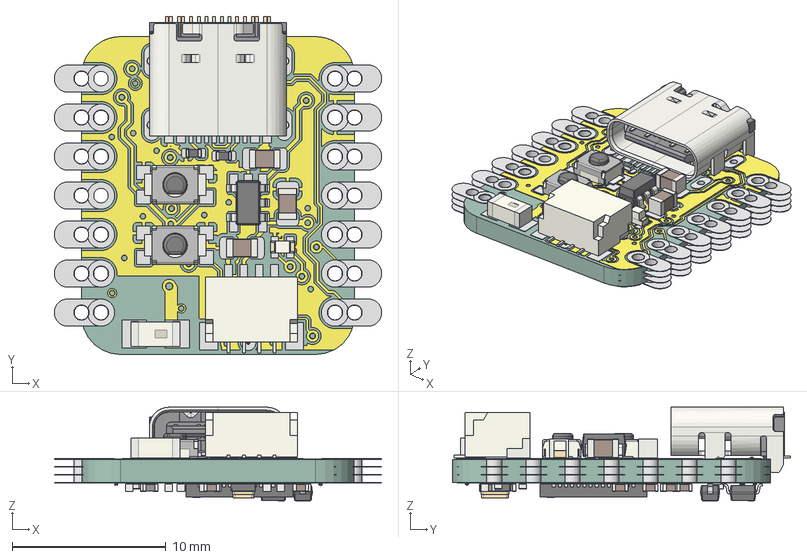
[picture p13: CAD file, 2026-10-27]
exports/renders/qt-py-esp32-s2-assembled.step
21.3 x 22.0 x 6.10 mm
SOT-23-5
C_0805_2012Metric x 3
USB_C_Receptacle_16P_TopMnt_Horizontal_GCT_USB4105-xx-A
SW_SPST_B3U-1000P x 2
R_0402_1005Metric x 6
Johanson_2450AT18x100
JST_SH_SM04B-SRSS-TB_1x04-1MP_P1.00mm_Horizontal
TestPoint_Keystone_5005_5009_Compact_cp x 6
LED_0603_1608Metric
C_0402_1005Metric x 15
L_0402_1005Metric x 2
D_SOD-323 x 2
a48c614c-8773-11ed-8f9d-58fb8493fcfb_part
a48c63fe-8773-11ed-8f9d-58fb8493fcfb_part
a48c65a2-8773-11ed-8f9d-58fb8493fcfb_part
a48c66d8-8773-11ed-8f9d-58fb8493fcfb_part
Crystal_SMD_2016-4Pin_2.0x1.6mm
qt-py-esp32-s2-assembled_copper
qt-py-esp32-s2-assembled_pad
qt-py-esp32-s2-assembled_via
qt-py-esp32-s2-assembled_PCB
