d4vid-le/qt-py-esp32-s2-experiment/rebuild/rebuild_netlist_connected.csv

net | ref | pad
+3V3 | C10 | 1
+3V3 | C11 | 1
+3V3 | C14 | 1
+3V3 | C15 | 1
+3V3 | C16 | 1
+3V3 | C19 | 1
+3V3 | C2 | 1
+3V3 | C4 | 1
+3V3 | C5 | 1
+3V3 | C6 | 1
+3V3 | C8 | 1
+3V3 | CONN1 | 2
+3V3 | JP3 | 5
+3V3 | JP3 | 5C
+3V3 | L1 | 1
+3V3 | R1 | 1
+3V3 | R2 | 1
+3V3 | U$15 | 1
+3V3 | U$15 | 20
+3V3 | U$15 | 27
+3V3 | U$15 | 45
+3V3 | U$15 | 51
+3V3 | U$15 | 54
+3V3 | U1 | 5
+5V | C1 | 1
+5V | D1 | C
+5V | D2 | C
+5V | JP3 | 7
+5V | JP3 | 7C
+5V | U1 | 1
+5V | U1 | 3
/A0 | JP1 | 1
/A0 | JP1 | 1C
/A0 | R2 | 2
/A0 | U$15 | 24
/A1 | JP1 | 2
/A1 | JP1 | 2C
/A1 | U$15 | 23
/A2 | JP1 | 3
/A2 | JP1 | 3C
/A2 | U$15 | 14
/A3 | JP1 | 4
/A3 | JP1 | 4C
/A3 | U$15 | 13
/CC1 | R6 | 2
/CC1 | X6 | A5
/CC2 | R5 | 2
/CC2 | X6 | B5
/D+ | U$15 | 26
/D+ | X6 | A6
/D+ | X6 | B6
/D- | U$15 | 25
/D- | X6 | A7
/D- | X6 | B7
/IO0 | Q1 | A
/IO0 | Q1 | A'
/IO0 | SWC2 | TP
/IO0 | U$15 | 5
/IO10_DBLTAP | C20 | 1
/IO10_DBLTAP | R17 | 2
/IO10_DBLTAP | U$15 | 15
/MISO | JP3 | 3
/MISO | JP3 | 3C
/MISO | U$15 | 41
/MOSI | JP3 | 4
/MOSI | JP3 | 4C
/MOSI | U$15 | 39
/NEOPIX | LED1 | 1
/NEOPIX | U$15 | 43
/NEOPIX_PWR | LED1 | 2
/NEOPIX_PWR | U$15 | 42
/RESET_N | C3 | 1
/RESET_N | Q2 | A
/RESET_N | Q2 | A'
/RESET_N | R1 | 2
/RESET_N | SWC1 | TP
/RESET_N | U$15 | 56
/RF_ANT | C9 | 1
/RF_ANT | L2 | 1
/RF_ANT | X1 | FP
/RF_LNA | C7 | 1
/RF_LNA | L2 | 2
/RF_LNA | U$15 | 2
/RX | JP3 | 1
/RX | JP3 | 1C
/RX | U$15 | 22
/SCK | JP3 | 2
/SCK | JP3 | 2C
/SCK | U$15 | 40
/SCL | JP1 | 6
/SCL | JP1 | 6C
/SCL | U$15 | 11
/SCL1 | CONN1 | 4
/SCL1 | U$15 | 44
/SDA | JP1 | 5
/SDA | JP1 | 5C
/SDA | U$15 | 12
/SDA1 | CONN1 | 3
/SDA1 | U$15 | 46
/TX | JP1 | 7
/TX | JP1 | 7C
/TX | U$15 | 10
/VBAT | D2 | A
/VBAT | VBAT0 | P$1
/VDD3P3 | L1 | 2
/VDD3P3 | U$15 | 3
/VDD3P3 | U$15 | 4
/VDD_SPI | C12 | 1
/VDD_SPI | C13 | 1
/VDD_SPI | U$15 | 30
/XTAL_N | C18 | 1
/XTAL_N | R3 | 1
/XTAL_N | Y1 | 1
/XTAL_N_R | R3 | 2
/XTAL_N_R | U$15 | 52
/XTAL_P | C17 | 1
/XTAL_P | U$15 | 53
/XTAL_P | Y1 | 3
GND | C1 | 2
GND | C10 | 2
GND | C11 | 2
GND | C12 | 2
GND | C13 | 2
GND | C14 | 2
GND | C15 | 2
GND | C16 | 2
GND | C17 | 2
GND | C18 | 2
GND | C19 | 2
GND | C2 | 2
GND | C20 | 2
GND | C3 | 2
GND | C4 | 2
GND | C5 | 2
GND | C6 | 2
GND | C7 | 2
GND | C8 | 2
GND | C9 | 2
GND | CONN1 | 1
GND | CONN1 | MT1
GND | CONN1 | MT2
GND | GND0 | P$1
GND | JP3 | 6
GND | JP3 | 6C
GND | LED1 | 4
GND | Q1 | B
GND | Q1 | B'
GND | Q2 | B
GND | Q2 | B'
GND | R17 | 1
GND | R5 | 1
GND | R6 | 1
GND | U$15 | 57
GND | U1 | 2
GND | X6 | A1B12
GND | X6 | B1A12
VBUS | D1 | A
VBUS | X6 | A4B9
VBUS | X6 | B4A9
