d4vid-le/qt-py-esp32-s2-experiment/(list of files, drawings)

Other design files:
rebuild/hybrid.dsn
rebuild/opt2.dsn
