d4vid-le/qt-py-esp32-s2-experiment/rebuild/qt-py-esp32-s2.kicad_pcb

## KiCad design rebuild/qt-py-esp32-s2.kicad_pcb (2026-10-27)

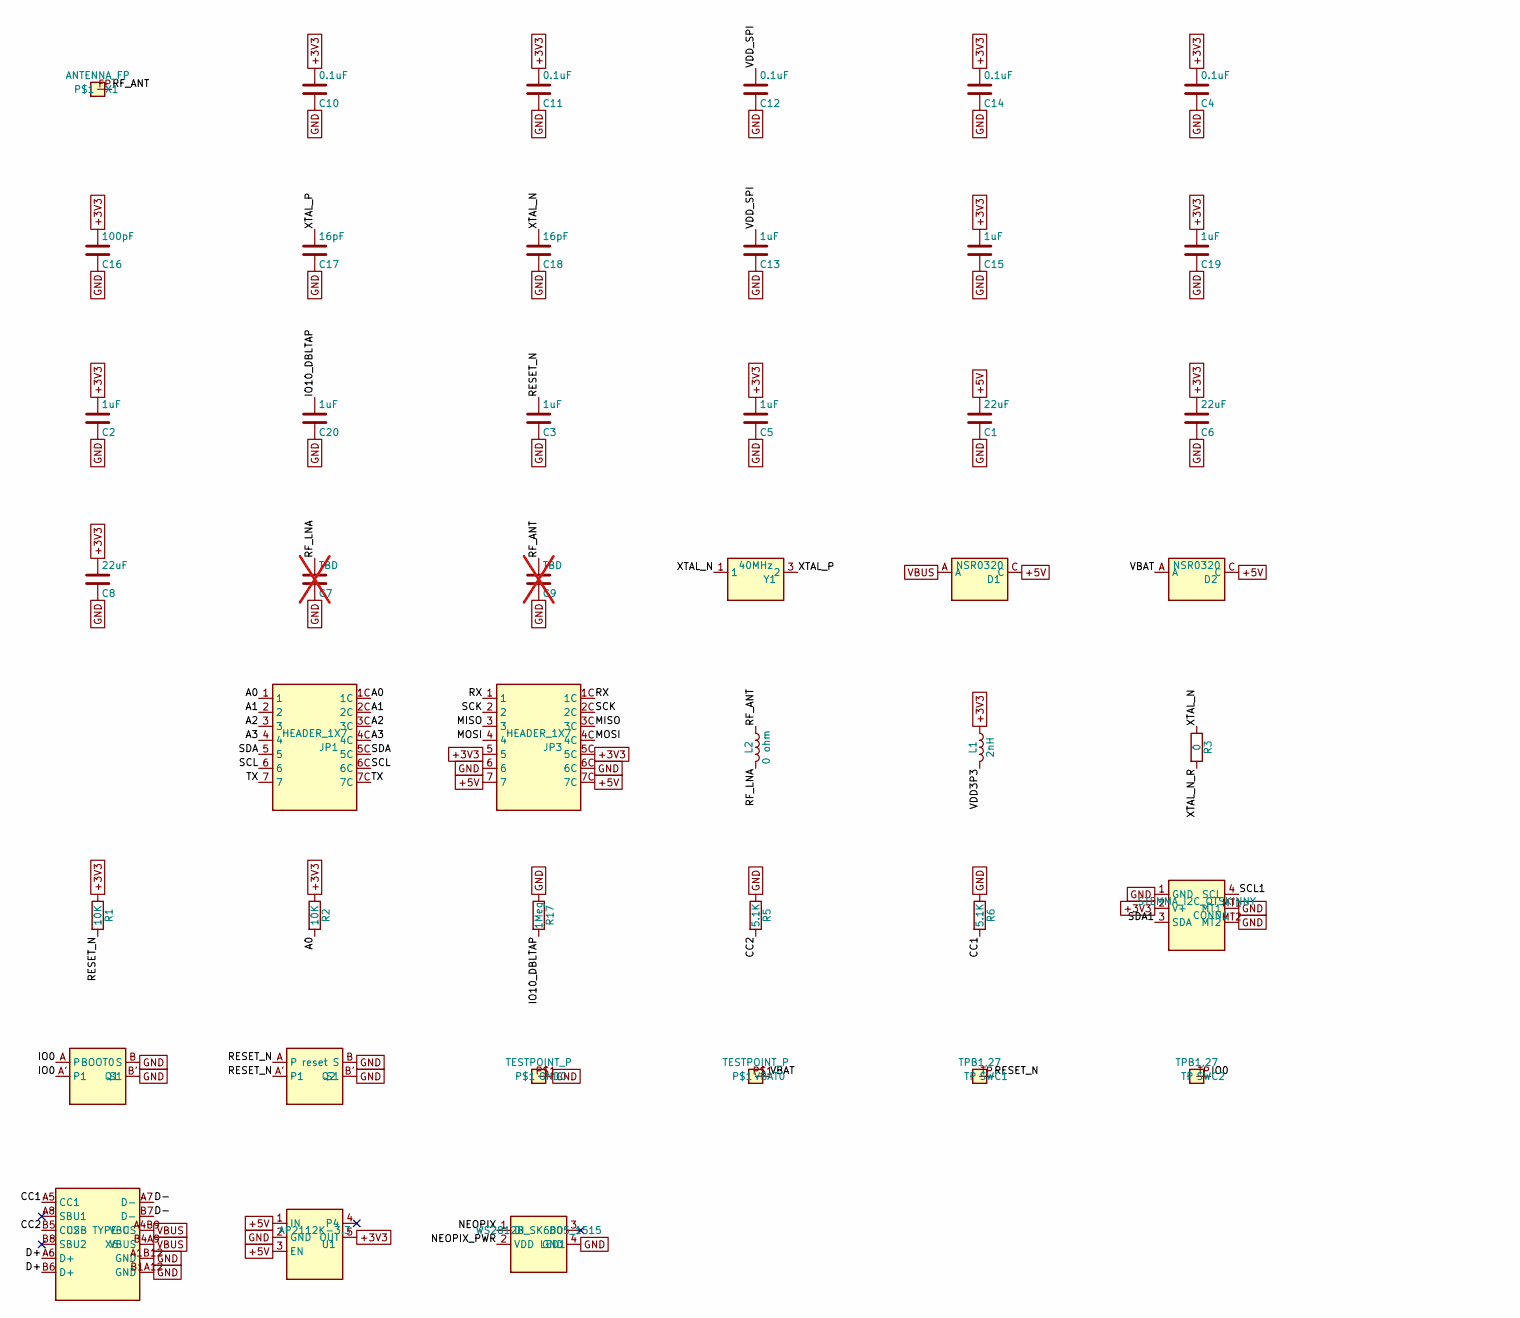
[picture p14: schematic qt-py-esp32-s2.kicad_sch, part in row 1, column 1]

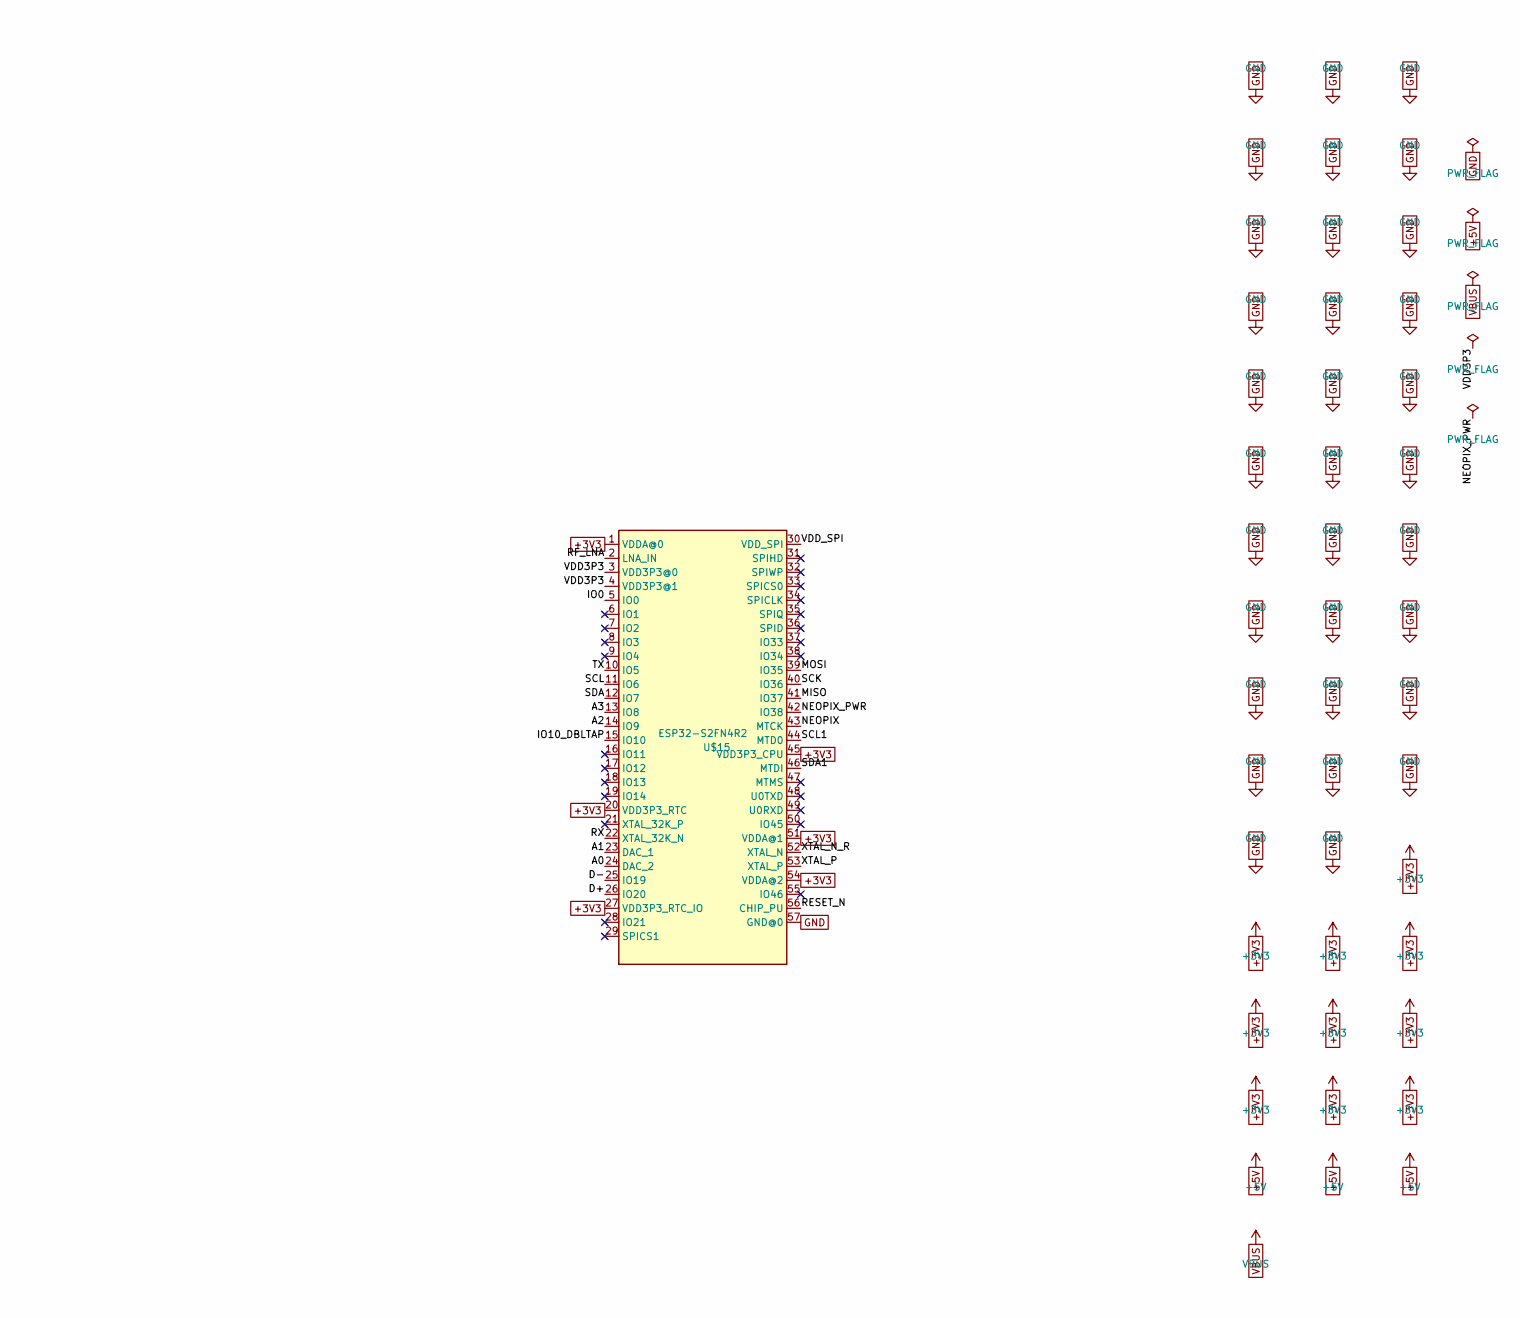
[picture p15: schematic qt-py-esp32-s2.kicad_sch, part in row 1, column 2]

Parts:
C1, C6, C8: 22uF; C_0805_2012Metric
C2, C3, C5, C13, C15, C19, C20: 1uF; C_0402_1005Metric
C4, C10, C11, C12, C14: 0.1uF; C_0402_1005Metric
C7, C9: TBD; C_0402_1005Metric; not fitted
C16: 100pF; C_0402_1005Metric
C17, C18: 16pF; C_0402_1005Metric
CONN1: STEMMA_I2C_QTSKINNY; JST_SH4_SKINNY
D1, D2: NSR0320; SOD-323_MINI
GND0: TESTPOINT_P; TESTPOINT_MINUS_1X3MM
JP1, JP3: HEADER_1X7; 1X07_CASTEL
L1: 2nH; L_0402_1005Metric
L2: 0 ohm; L_0402_1005Metric
LED1: WS2812B_SK6805_1515; SK6805_1515
Q1: BOOT0; BTN_KMR2_4.6X2.8
Q2: reset; BTN_KMR2_4.6X2.8
R1, R2: 10K; R_0402_1005Metric
R3: 0; R_0402_1005Metric
R5, R6: 5.1K; R_0402_1005Metric
R17: 1Meg; R_0402_1005Metric
SWC1, SWC2: TPB1,27; B1_27
U1: AP2112K-3.3; SOT23-5
U$15: ESP32-S2FN4R2; QFN56_7X7
VBAT0: TESTPOINT_P; TESTPOINT_PLUS_1X3MM
X1: ANTENNA_FP; ANT_2450AT18B100
X6: USB TYPE C; USB_C_CUSB31-CFM2AX-01-X
Y1: 40MHz; CRYSTAL_2X1.6

Connections:
+3V3: C2.1, C4.1, C5.1, C6.1, C8.1, C10.1, C11.1, C14.1, C15.1, C16.1, C19.1, CONN1.2 (V+), JP3.5, JP3.5C, L1.1, R1.1, R2.1, U1.5 (OUT), U$15.1 (VDDA@0), U$15.20 (VDD3P3_RTC), U$15.27 (VDD3P3_RTC_IO), U$15.45 (VDD3P3_CPU), U$15.51 (VDDA@1), U$15.54 (VDDA@2)
+5V: C1.1, D1.C, D2.C, JP3.7, JP3.7C, U1.1 (IN), U1.3 (EN)
A0: JP1.1, JP1.1C, R2.2, U$15.24 (DAC_2)
A1: JP1.2, JP1.2C, U$15.23 (DAC_1)
A2: JP1.3, JP1.3C, U$15.14 (IO9)
A3: JP1.4, JP1.4C, U$15.13 (IO8)
CC1: R6.2, X6.A5 (CC1)
CC2: R5.2, X6.B5 (CC2)
D+: U$15.26 (IO20), X6.A6 (D+), X6.B6 (D+)
D-: U$15.25 (IO19), X6.A7 (D-), X6.B7 (D-)
GND: C1.2, C2.2, C3.2, C4.2, C5.2, C6.2, C7.2, C8.2, C9.2, C10.2, C11.2, C12.2, C13.2, C14.2, C15.2, C16.2, C17.2, C18.2, C19.2, C20.2, CONN1.1 (GND), CONN1.MT1, CONN1.MT2, GND0.P$1, JP3.6, JP3.6C, LED1.4 (GND), Q1.B (S), Q1.B' (S1), Q2.B (S), Q2.B' (S1), R5.1, R6.1, R17.1, U1.2 (GND), U$15.57 (GND@0), X6.A1B12 (GND), X6.B1A12 (GND)
IO0: Q1.A, Q1.A' (P1), SWC2.TP, U$15.5 (IO0)
IO10_DBLTAP: C20.1, R17.2, U$15.15 (IO10)
MISO: JP3.3, JP3.3C, U$15.41 (IO37)
MOSI: JP3.4, JP3.4C, U$15.39 (IO35)
NEOPIX: LED1.1 (DI), U$15.43 (MTCK)
NEOPIX_PWR: LED1.2 (VDD), U$15.42 (IO38)
RESET_N: C3.1, Q2.A, Q2.A' (P1), R1.2, SWC1.TP, U$15.56 (CHIP_PU)
RF_ANT: C9.1, L2.1, X1.FP
RF_LNA: C7.1, L2.2, U$15.2 (LNA_IN)
RX: JP3.1, JP3.1C, U$15.22 (XTAL_32K_N)
SCK: JP3.2, JP3.2C, U$15.40 (IO36)
SCL: JP1.6, JP1.6C, U$15.11 (IO6)
SCL1: CONN1.4 (SCL), U$15.44 (MTD0)
SDA: JP1.5, JP1.5C, U$15.12 (IO7)
SDA1: CONN1.3 (SDA), U$15.46 (MTDI)
TX: JP1.7, JP1.7C, U$15.10 (IO5)
VBAT: D2.A, VBAT0.P$1
VBUS: D1.A, X6.A4B9 (VBUS), X6.B4A9 (VBUS)
VDD3P3: L1.2, U$15.3 (VDD3P3@0), U$15.4 (VDD3P3@1)
VDD_SPI: C12.1, C13.1, U$15.30 (VDD_SPI)
XTAL_N: C18.1, R3.1, Y1.1
XTAL_N_R: R3.2, U$15.52 (XTAL_N)
XTAL_P: C17.1, U$15.53 (XTAL_P), Y1.3 (2)

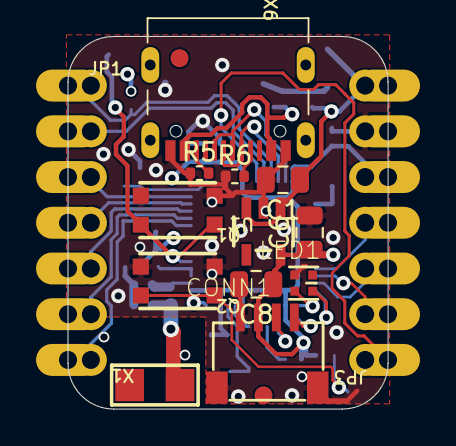
[picture p16: board qt-py-esp32-s2.kicad_pcb from above]

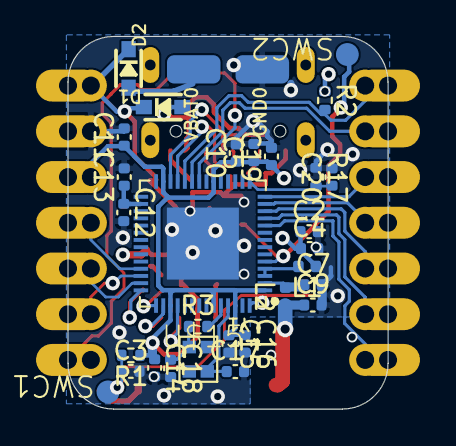
[picture p17: board qt-py-esp32-s2.kicad_pcb from below]

Board: 4 copper layers, 17.8 x 20.7 mm, 47 parts (31 on the bottom side), 34 nets.

Other parts of the board:
FID1, FID2: FIDUCIAL_1MM
