d4vid-le/qt-py-esp32-s2-experiment/(commit log)

2026-10-27 Gate 0: inventory and netlist ground truth for QT Py ESP32-S2 Rev C
    - clone Adafruit Eagle source at 7df4eac (pinned, read-only)
    - parse Rev C .sch -> reference/netlist.csv, bom.csv, pinmap.csv
    - add nets.csv, unconnected.csv, gate0-nets.md
    - cross-check .sch netlist against .brd contactrefs: 34/34 nets, 0 mismatches
    - design/STATE.md + design/gate0-inventory.md
    Rev C evidence: antenna R270->R180, VDD_SPI split from 3.3V, U$22 removed.
    [bom.csv, netlist.csv, nets.csv, pinmap.csv, unconnected.csv]
2026-10-27 gate1: ground truth — Eagle board import and netlist diff
    - import Rev C .brd with kicad-cli (eagle), 0 errors
    - extract pad netlist from the imported .kicad_pcb (stdlib S-expr parser)
    - diff by connectivity signature: 34/34 nets, 159/159 pads
    - only diffs: GND->GND0, VBAT->VBAT0 ref renames; !RESET->~{RESET}
    - document importer defect: Eagle user layers 200/201 -> UNDEFINED (5385 items)
    - clean physical BOM: 45 components / 26 groups, C7+C9 DNP
    - correct count reconciliation (187 connected, 215 total symbol pins)
    - adopt public layout: design/, reports/, scripts/, renders/, rebuild/
    - scripts/fetch-reference.sh; Adafruit files remain gitignored
    [bom_clean.csv, bom_original.csv, bom_symbols.csv, netlist_original.csv, nets.csv, pinmap.csv, unconnected.csv]
2026-10-27 gate1: add imported-board render from viz-only repaired copy
    Authoritative import stays untouched; 5385 UNDEFINED graphics moved to
    Dwgs.User in a separate copy so the board can be rendered.
2026-10-27 gate1: U$15 pin audit, MCP backend test, data hygiene
    - identify U$15 as ESP32-S2FN4R2 (QFN56, 4MB flash + 2MB PSRAM)
    - audit all 57 pads against datasheet: 57/57 name match, 33 connected
    - device label QFN54 is wrong; package QFN56_7X7 with 57 pads is correct
    - confirm with Adafruit datasheet v1.1 + Espressif v1.9 (FN4R2 ordering)
    - MCP SWIG backend verified on known-good board; import fails only on UNDEFINED
    - viz copy equivalence: normalized bytes identical, nets/pads/tracks unchanged
    - nets.csv: replace ambiguous pin_count with unique_pins/pad_count/power_pins
    - license verified CC BY-SA 3.0 Unported and linked in README
    - schematic import deliberately skipped (human Option 2)
    [nets.csv, u15-pinmap.csv]
2026-10-27 gate2: schematic reconstruction — 34/34 nets, 0 ERC errors
    - 12 custom symbols whose pin numbers equal the Eagle pad names
    - ESP32-S2FN4R2 57-pin symbol from design/u15-pinmap.csv
    - 96 symbol instances: 45 components + 46 power symbols + 5 PWR_FLAGs
    - 187 connections via labels (global power, local signals), 28 no-connects
    - netlist diff vs ground truth: 34/34 nets, 159/159 pads, identical
    - ERC: 0 errors, 35 warnings (17 footprint-library, 17 formatting-only, 1 intentional)
    - fixed 2 errors found: NEOPIX_PWR undriven, +3V3 double-driven
    - document MCP loader bug: symbol name matching _<n>_<n> suffix is rejected
    - document 30s batch_connect timeout and chunking workaround
    - qt-py footprint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
    [gate2-components.csv, netlist-diff.txt, qt-py-esp32-s2.kicad_pcb, qt-py-esp32-s2.kicad_sch, rebuild_netlist_connected.csv]
2026-10-27 gate3: PCB placement — 45/45 placed, 17.78x20.701 outline, DRC run
    - qt-py footprint library extracted from the imported board (14 footprints)
    - pad names preserved: A/A'/B/B', 1C..7C, A1B12/A4B9/A6/B6, MT1/MT2, C/A, 1/3, FP, P$1, TP
    - create_board_from_schematic: 45 footprints, 34 nets, 159 pads assigned
    - placement copied from the imported board: 45/45 exact x/y/rotation/layer
    - outline 17.78 x 20.701 (8 Edge.Cuts segments), 2 fiducials, no frame
    - Eagle rules: 6 mil clearance/width, 15.5 mil drill, 25% annulus, 0.254 edge, 2L 1.6mm
    - fixed castellation pad rotation (importer stored 270/90): shorts 26 -> 2
    - ERC footprint_link_issues 17 -> 0; annotation warning cleared via GND0/VBAT0
    - D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
    [gate3-placement-source.csv, gate3-placement.csv, qt-py-esp32-s2.kicad_pcb, qt-py-esp32-s2.kicad_sch, rebuild_netlist_connected.csv]
2026-10-27 gate4: routing — 0 DRC errors, 20 unconnected documented
    preconditions:
    - testpoint no-net copper polygon -> equivalent P$1 pad; courtyard closed
    - removed ${TP_SIGNAL_NAME} from B1_27 and placed SWC instances
    - USB-C NPTH resized 1.158 -> 0.65 mm to match Eagle drill
    - documented waivers: castellation edge, USB-C internal holes, courtyard overlap
    routing:
    - Freerouting 2.5.0, 200 passes, 18 threads; 125 -> 24 unrouted; SES imported
    - GND pours on F.Cu/B.Cu, solid pad connection
    - 323 segments, 18 vias, 298.86 mm total
    - DRC 0 errors, 196 cosmetic warnings, 20 unconnected (13 GND, 4 +3V3, 2 VBUS, 1 IO0)
    honest shortfall:
    - 20 connections remain unrouted; not intentional
    - D+/D- skew 3.51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
    [qt-py-esp32-s2.kicad_pcb]
2026-10-27 gate4b: routing completion attempted — blocked, 20 unconnected remain
    Six completion strategies tried and documented:
    - via-in-pad at isolated GND pads (14 shorts)
    - adjacent 0.5/0.3 vias + stubs (8 shorts, 7 drill/via errors)
    - original GND mesh additive (15 unconnected, 13 shorts)
    - hybrid GND/+3V3/VBUS/IO0 replacement (11 unconnected, 32 shorts)
    - targeted +3V3/VBUS/IO0 replacement (15 unconnected, 17 shorts)
    - Freerouting 200 passes (24 unrouted)
    Root cause: GND pours fragmented into 14 islands by our signal tracks; the
    reference power mesh fits Adafruit's signal routing, not ours; no interactive
    router is exposed; DSN wires are (type route), not protect.
    Final board reverted to the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
    [hybrid.dsn]
2026-10-27 gate4b WIP: GND stitching 20->14, blocked on pour-island links
    - 7 stitching vias at F/B fill intersections; main pours merged
    - cleared CONN1.MT1/C17.2 and X6 zone links
    - 20 -> 14 unconnected, 0 DRC errors, no new waivers
    - remaining 7 GND links separated by our signal tracks; need signal reroute
    - +3V3 reference geometry tried: 13 unconnected but 36 errors; reverted
    - USB-C NPTH 0.65 mm source reference retained
    - still NOT COMPLETE; no Gerbers/fabrication
    [qt-py-esp32-s2.kicad_pcb]
2026-10-27 gate4b: blocker analysis for C7/Q2/C4 GND island
    - 14 unconnected / 0 errors retained
    - identified +3V3 B.Cu diagonal, TX/SCL/RX tracks as island separators
    - reference board keeps GND connected via inner-layer zones; 2-layer rebuild cannot
    - tried 3-segment +3V3 detour at x=4.5: 2 clearance errors to L1.2, no gain; reverted
    - corridor 0.55 mm vs 0.559 mm required for 0.254 track + 2x0.1524 clearance
    - stopped before option 2 per rule 7
2026-10-27 gate4b: option 2 stalls at 9 unconnected / 0 errors
    - reference power/GND mesh protected in DSN; Freerouting 11 unrouted
    - imported SES, vias fixed: 13/0; pour stitching: 9/0
    - reference signal corridors for last six nets: 5 unconnected but 39 errors; reverted
    - remaining 9: 1 GND island pair, 2 +3V3 gaps, D+/A0/SDA/TX/RX/MISO pad escapes
    - USB skew still 3.51 mm, not tuned
    - both option 1 and option 2 exhausted under no-wholesale-copy
    - NOT COMPLETE; no Gate 5, no Gerbers
    [opt2.dsn, qt-py-esp32-s2.kicad_pcb]
2026-10-27 gate4b: source is 4-layer; 2-layer 3V3 plane dependency blocks 9 links
    - Eagle layerSetup (1+2*15+16), In1/In2 zones, 3.3V plane on In2
    - reference 3.3V net is connected through the In2 plane, not F/B segments
    - targeted 3V3 replacement + local pours left 9 unconnected, 0 errors
    - final: 9 unconnected / 0 DRC errors; USB 3.51 mm
    - provenance table added (model-routed vs reference-assisted)
    - stopped; 4-layer needs explicit approval, no fabrication
    [replace_net_ref.py]
2026-10-27 gate4b/gate5: PASS as verified reconstruction; manufacturing outputs
    - 4-layer source-faithful stack (In1 GND, In2 3.3V) approved; planes added
    - reference zones restored; solid zone_connect on C15.2/C3.2/R6.1
    - full reference signal routing fallback applied (approved)
    - DRC 0 errors / 0 unconnected; D+ 9.238, D- 8.145, skew 1.093 mm
    - C7/C9 marked DNP in schematic/board/BOM/PnP
    - Gerbers (4 copper), PTH/NPTH drill, BOM, pos, stats, 2D/3D renders
    - no fabrication, no ordering, no unconnected/DRC waivers
    [bom.csv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]
2026-10-27 mockup: assembled 3D visualization from final board
    - copy at mockup/qt-py-esp32-s2-assembled.kicad_pcb; rebuild/ untouched
    - 17 models added: QFN56, USB-C, JST-SH, buttons, antenna, SOT23-5,
    SOD-323 x2, crystal, LED placeholder, testpoint/fiducial placeholders
    - exact KiCad models for passives/QFN/regulator/diodes/crystal
    - representative/placeholder shells labeled in gate5 report
    - four 2400x1800 raytraced views (top, bottom, top/bottom isometric)
    - assembled STEP (13 MB) and GLB (1.7 MB)
    - no electrical, Gerber, BOM, DRC, or drill changes
    [qt-py-esp32-s2-assembled.kicad_pcb, qt-py-esp32-s2-assembled.step]
